theapi/pwm-charge-controller/README.md

# PWM Charge Controller

PWM solar charge controller, with common ground.
