theapi/pwm-charge-controller/datasheets/meter.jpg

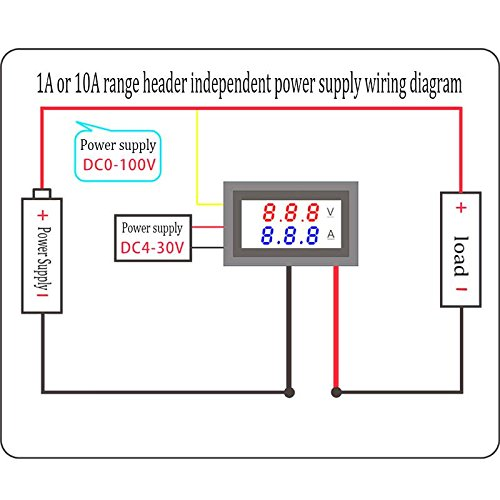
datasheets/meter.jpg
