theapi/pwm-charge-controller/kicad/render-bottom.png

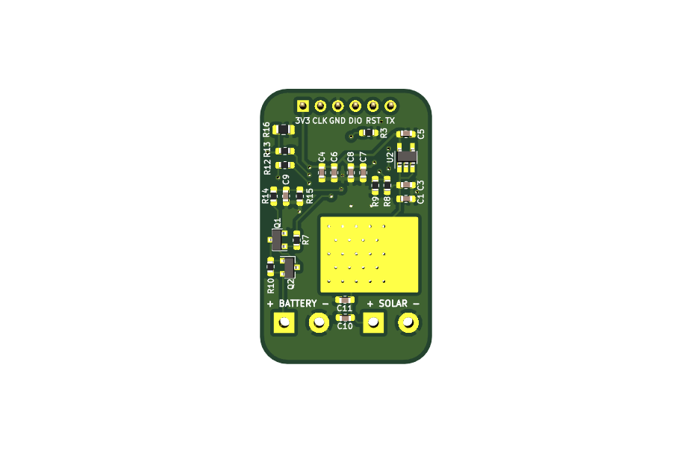
kicad/render-bottom.png
