theapi/pwm-charge-controller/kicad/project.pdf

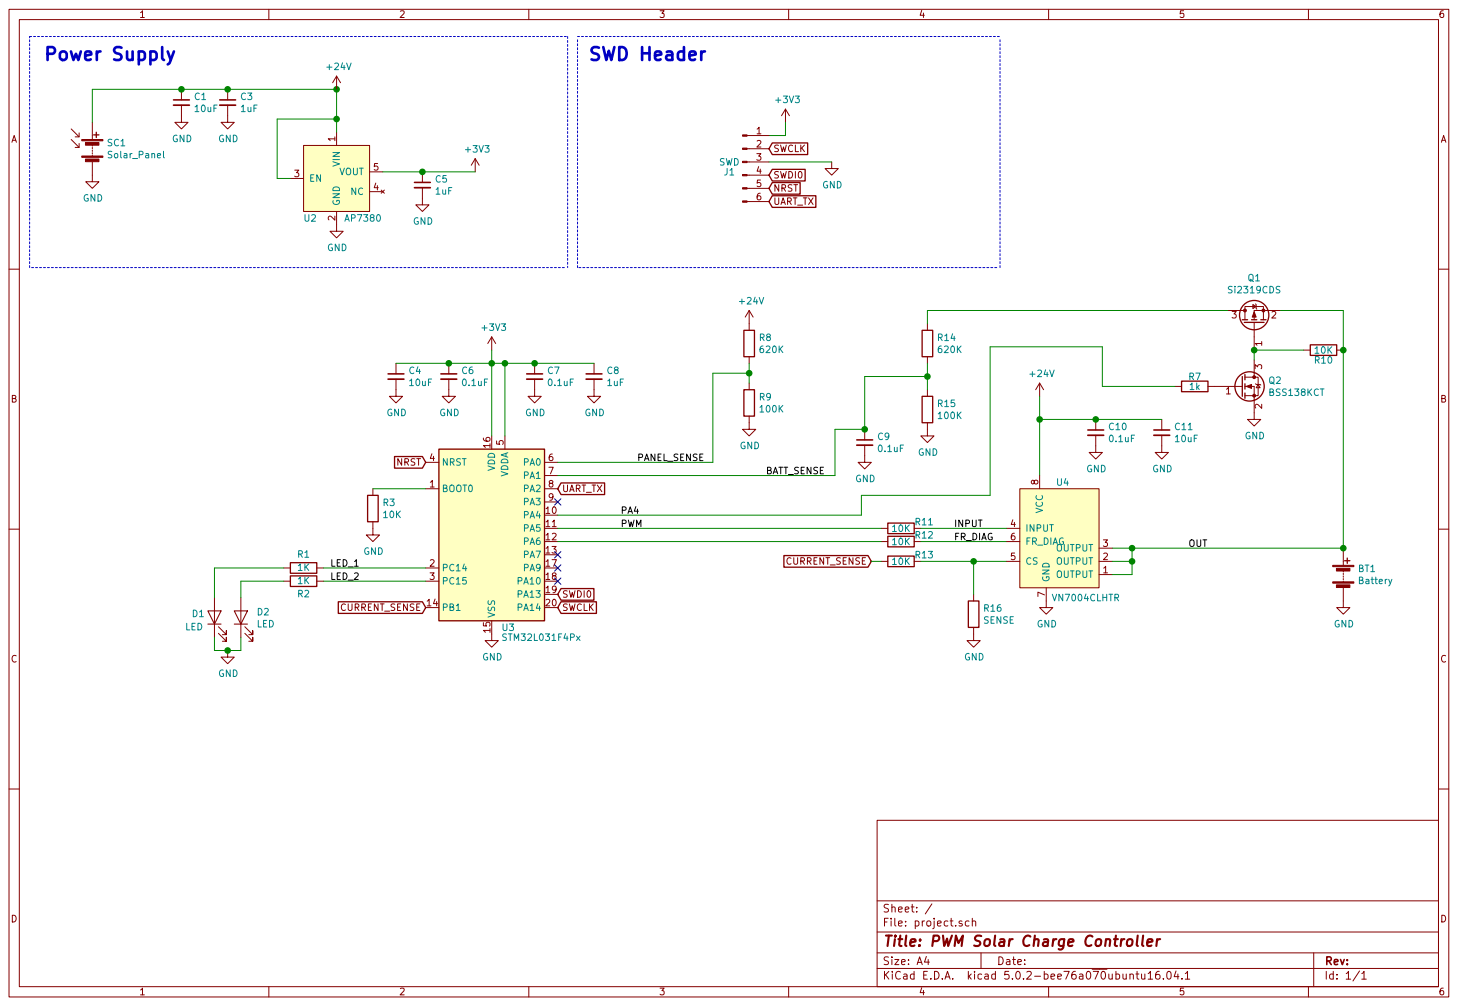
[picture p5: page 1]

Id: 1/1 Title: PWM Solar Charge Controller
