theapi/pwm-charge-controller/kicad/project/project.kicad_pcb

## KiCad design kicad/project/project.kicad_pcb (2019-07-06)

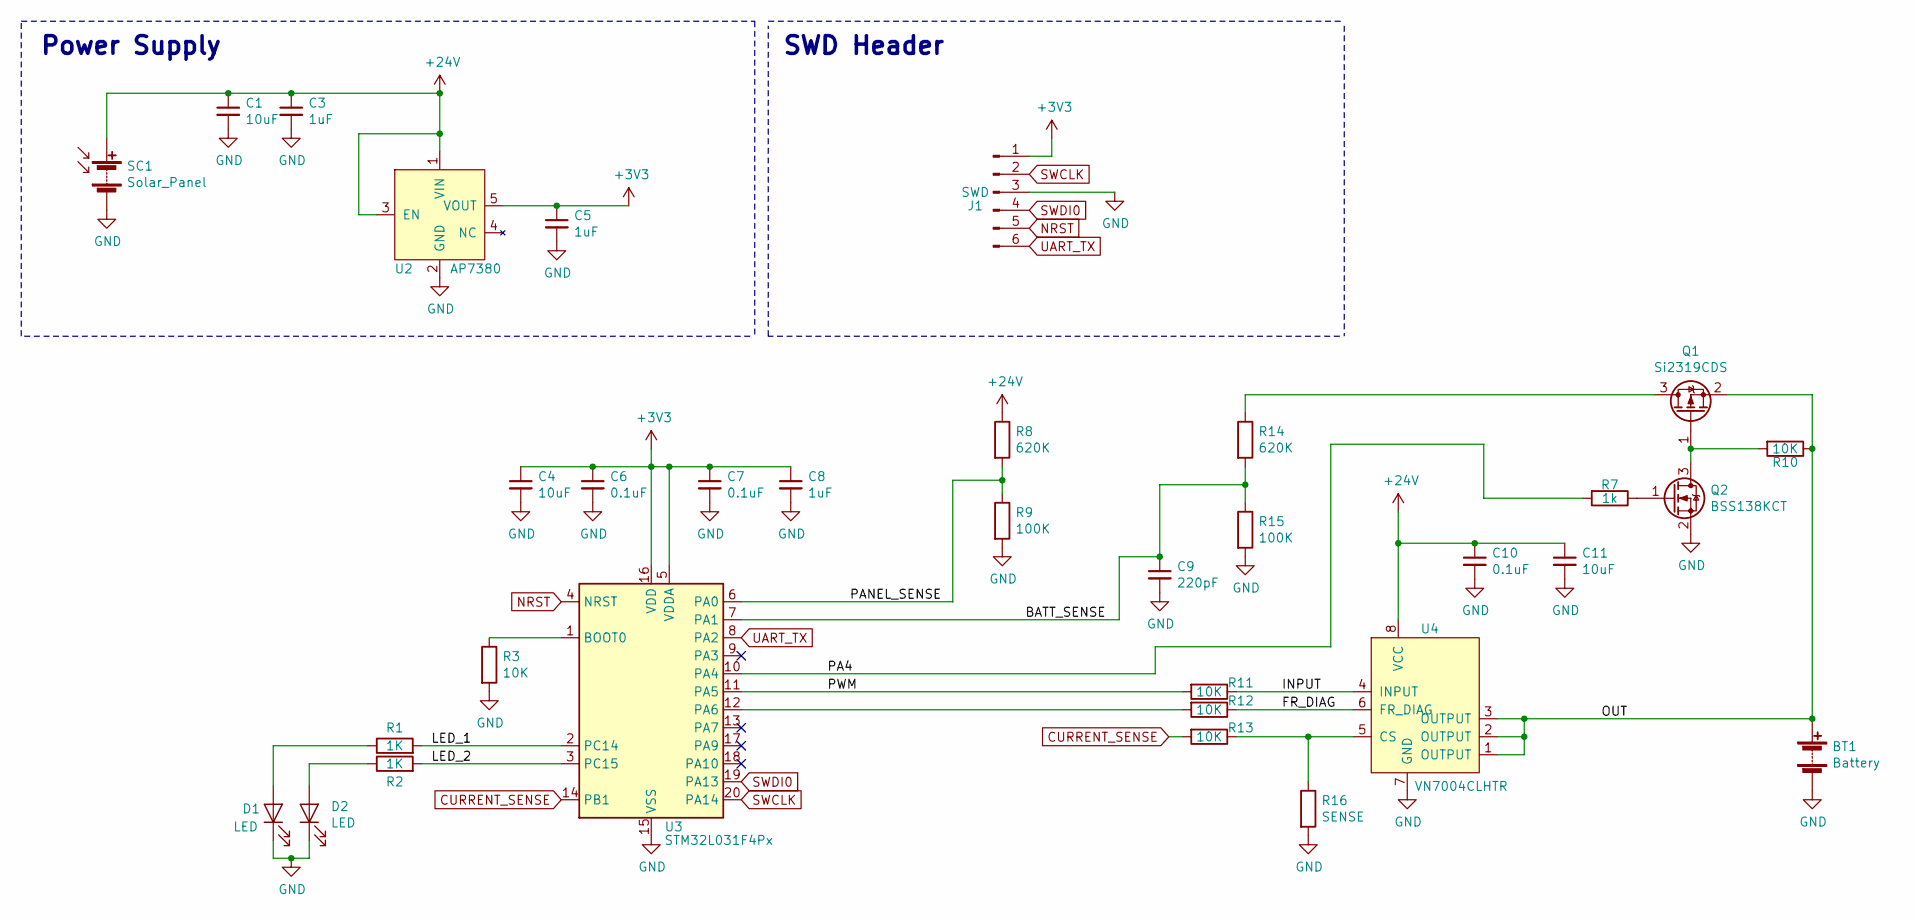
[picture p6: schematic project.sch, PWM Solar Charge Controller]

Parts:
BT1: Battery; TerminalBlock_2_P5.08mm
C1, C4, C11: 10uF; C_0603_1608Metric_Pad1.05x0.95mm_HandSolder
C3, C5, C8: 1uF; C_0603_1608Metric_Pad1.05x0.95mm_HandSolder
C6, C7, C10: 0.1uF; C_0603_1608Metric_Pad1.05x0.95mm_HandSolder
C9: 220pF; C_0603_1608Metric_Pad1.05x0.95mm_HandSolder
D1, D2: LED; LED_0805_2012Metric_Pad1.15x1.40mm_HandSolder
J1: SWD; PinHeader_1x06_P2.54mm_Vertical
Q1: Si2319CDS; SOT-23
Q2: BSS138KCT; SOT-23
R1, R2: 1K; R_0603_1608Metric_Pad1.05x0.95mm_HandSolder
R3, R10, R11, R12, R13: 10K; R_0603_1608Metric_Pad1.05x0.95mm_HandSolder
R7: 1k; R_0603_1608Metric_Pad1.05x0.95mm_HandSolder
R8, R14: 620K; R_0603_1608Metric_Pad1.05x0.95mm_HandSolder
R9, R15: 100K; R_0603_1608Metric_Pad1.05x0.95mm_HandSolder
R16: SENSE; R_0805_2012Metric_Pad1.15x1.40mm_HandSolder
SC1: Solar_Panel; TerminalBlock_2_P5.08mm
U2: AP7380; SOT-23-5_HandSoldering
U3: STM32L031F4Px; TSSOP-20_4.4x6.5mm_P0.65mm
U4: VN7004CLHTR; Octapak

Connections:
+3V3: C4.1, C5.1, C6.1, C7.1, C8.1, J1.1, U2.5 (VOUT), U3.5 (VDDA), U3.16 (VDD)
+24V: C1.1, C3.1, C10.1, C11.1, R8.1, SC1.1 (+), U2.1 (VIN), U2.3 (EN), U4.8 (VCC)
/BATT_SENSE: C9.1, R14.2, R15.1, U3.7 (PA1)
/FR_DIAG: R12.1, U4.6 (FR_DIAG)
/INPUT: R11.1, U4.4 (INPUT)
/LED_1: R1.2, U3.2 (PC14)
/LED_2: R2.2, U3.3 (PC15)
/OUT: BT1.1 (+), Q1.2 (S), R10.1, U4.1 (OUTPUT), U4.2 (OUTPUT), U4.3 (OUTPUT)
/PA4: R7.2, U3.10 (PA4)
/PANEL_SENSE: R8.2, R9.1, U3.6 (PA0)
/PWM: R11.2, U3.11 (PA5)
CURRENT_SENSE: R13.2, U3.14 (PB1)
GND: BT1.2 (-), C1.2, C3.2, C4.2, C5.2, C6.2, C7.2, C8.2, C9.2, C10.2, C11.2, D1.1 (K), D2.1 (K), J1.3, Q2.2 (S), R3.2, R9.2, R15.2, R16.2, SC1.2 (-), U2.2 (GND), U3.15 (VSS), U4.7 (GND)
NRST: J1.5, U3.4 (NRST)
unnamed: D1.2 (A), R1.1
unnamed: D2.2 (A), R2.1
unnamed: Q1.1 (G), Q2.3 (D), R10.2
unnamed: Q1.3 (D), R14.1
unnamed: Q2.1 (G), R7.1
unnamed: R3.1, U3.1 (BOOT0)
unnamed: R12.2, U3.12 (PA6)
unnamed: R13.1, R16.1, U4.5 (CS)
SWCLK: J1.2, U3.20 (PA14)
SWDI0: J1.4, U3.19 (PA13)
UART_TX: J1.6, U3.8 (PA2)

Notes on the sheet:
Power Supply
SWD Header

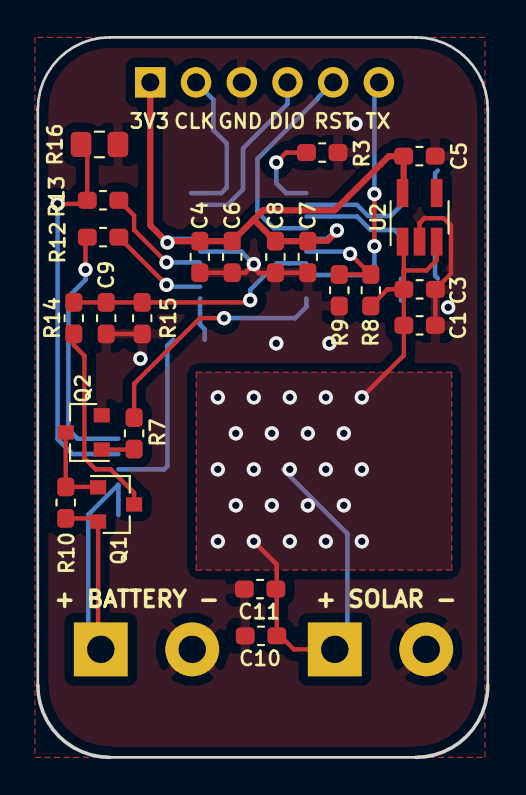
[picture p7: board project.kicad_pcb from above]

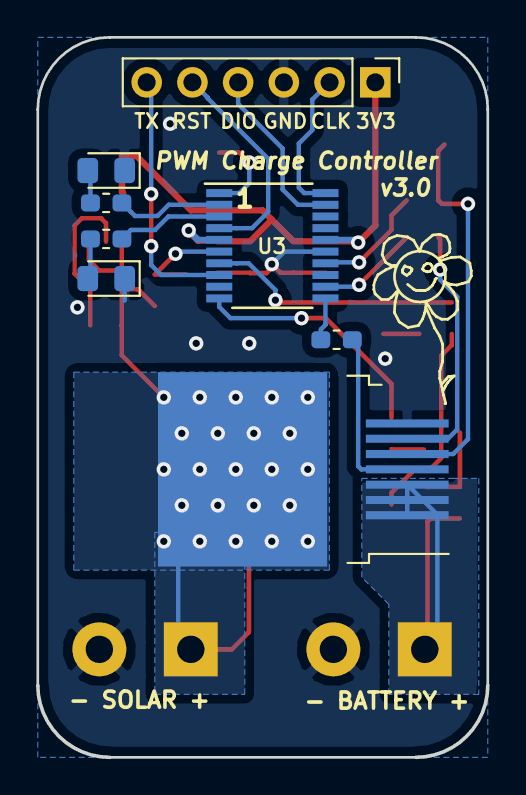
[picture p8: board project.kicad_pcb from below]

Board: 2 copper layers, 25.0 x 40.0 mm, 33 parts (10 on the bottom side), 25 nets.
