theapi/pwm-charge-controller/stm32/charge-controller/Src/main.c

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

/* Includes ------------------------------------------------------------------*/
#include "main.h"
#include "adc.h"
#include "comp.h"
#include "dma.h"
#include "tim.h"
#include "gpio.h"

/* USER CODE BEGIN Includes */

#include "string.h"
#include "stdio.h"

#include "led.h"


/* USER CODE END Includes */

/* USER CODE BEGIN PD */

/* Definition of ADCx conversions data table size */
#define ADC_CONVERTED_DATA_BUFFER_SIZE   ((uint32_t)  512)   /* Size of array aADCxConvertedData[] */

#define TXBUFFERSIZE 128
#define READING_INDEX_LENGTH 4


/* USER CODE END PD */


/* USER CODE BEGIN PV */
/* Variable containing ADC conversions data */
static uint16_t aADCxConvertedData[ADC_CONVERTED_DATA_BUFFER_SIZE];
static uint16_t avgPA1;
/* The comparator sets/resets this variable when comparing PA0 & PA1 */
volatile uint8_t comparator = 0;


/* Buffer used for debug UART */
char tx_buffer[TXBUFFERSIZE];
uint8_t msg_id = 0;

uint32_t tx_last;
uint32_t panel_mv = 0;
uint32_t battery_mv = 0;

LED_HandleTypeDef led1;
LED_HandleTypeDef led2;


/* USER CODE END PV */

void SystemClock_Config(void);
/**
  * @brief  The application entry point.
  * @retval int
  */
int main(void)
{
  

  /* MCU Configuration--------------------------------------------------------*/

  /* Reset of all peripherals, Initializes the Flash interface and the Systick. */
  HAL_Init();

  /* Configure the system clock */
  SystemClock_Config();

  /* Initialize all configured peripherals */
  MX_GPIO_Init();
  MX_DMA_Init();
  MX_TIM2_Init();
  MX_ADC_Init();
  MX_COMP1_Init();
  /* USER CODE BEGIN 2 */


  LED_Init(&led1, GPIOC, LED_1_Pin);
  led1.onDuration = 100;
  led1.offDuration = 900;

  LED_Init(&led2, GPIOC, LED_2_Pin);
  led2.offDuration = 500;
  LED_on(&led2);

  if (HAL_ADCEx_Calibration_Start(&hadc, ADC_SINGLE_ENDED) !=  HAL_OK)
  {
    Error_Handler();
  }

  HAL_COMP_Start(&hcomp1);

  /* Start conversion in DMA mode ################################# */
  if (HAL_ADC_Start_DMA(&hadc,
                        (uint32_t *)aADCxConvertedData,
                        ADC_CONVERTED_DATA_BUFFER_SIZE
                       ) != HAL_OK)
  {
    Error_Handler();
  }

  htim2.Instance->CCR1 = 0;
  HAL_TIM_PWM_Start(&htim2, TIM_CHANNEL_1);


  // This is the driver pin for connecting the battery to the adc.
  // So the battery can always be connected but present no voltage
  // to the adc until it is powered.
  HAL_GPIO_WritePin(GPIOA, GPIO_PIN_4, GPIO_PIN_SET);



  /* USER CODE END 2 */

  /* Infinite loop */
  /* USER CODE BEGIN WHILE */
  while (1)
  {
    /* USER CODE END WHILE */

    /* USER CODE BEGIN 3 */

	  uint32_t tmpAvgPA1 = 0;
	  uint16_t i = 0;
	  while (i < ADC_CONVERTED_DATA_BUFFER_SIZE) {
		  /* PA1 is the battery */
		  tmpAvgPA1 += aADCxConvertedData[i];
		  i++;
	  }
	  // Use the average.
 	  avgPA1 = tmpAvgPA1 / ADC_CONVERTED_DATA_BUFFER_SIZE;

	  // 2330 = 13519 = 5.802145923 per bit
 	  // 13609 = 2327 = 5.848302535
 	  // 2310 13523 5.854112554
	  battery_mv = (avgPA1 * 5854) / 1000;

	  // If the comparator says the panel is a higher voltage than the battery
	  // then charge.
	  if (comparator) {
		  if (battery_mv > 13510) {
			  if (htim2.Instance->CCR1 > 0) {
				  htim2.Instance->CCR1 -= 1;
			  }
		  } else if (battery_mv < 13490){
			  if (htim2.Instance->CCR1 < 1000) {
				  htim2.Instance->CCR1 += 1;
			  }
		  }
	  } else {
		  // Not enough to do charging.
		  htim2.Instance->CCR1 = 0;
	  }


	  /* Set the leds */
	  if (htim2.Instance->CCR1 == 1000) {
		  LED_on(&led2);
	  } else if (htim2.Instance->CCR1 == 0) {
		  LED_off(&led2);
	  } else {
		  led2.onDuration = htim2.Instance->CCR1;
		  LED_flash(&led2);
	  }

	  /* A continual flash to indicate powered on */
	  LED_flash(&led1);

	 // HAL_Delay(20);

//	  uint32_t now = HAL_GetTick();
//	  if (now - tx_last >= 500) {
//		  tx_last = now;
//		  int tx_len = snprintf(
//				  tx_buffer,
//				  TXBUFFERSIZE,
//				  "msg_id:%d, batt:%lu, panel:%lu, ccr:%lu \n",
//				  msg_id++,
//				  battery_mv,
//				  panel_mv,
//				  htim2.Instance->CCR1
//		  );
//		  HAL_UART_Transmit(&huart2, (uint8_t *)tx_buffer, tx_len, 500);
//	  }



  }
  /* USER CODE END 3 */
}

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
/* USER CODE BEGIN 4 */

void HAL_COMP_TriggerCallback(COMP_HandleTypeDef *hcomp) {
	if (HAL_COMP_GetOutputLevel(hcomp)) {
		comparator = 1;
	} else {
		comparator = 0;
	}
}

/* USER CODE END 4 */
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
