theapi/pwm-charge-controller/stm32/charge-controller/charge-controller.ioc

Mcu.UserName=STM32L031F4Px
PA0-CK_IN.Signal=COMP1_INM
PA1.Signal=SharedAnalog_PA1
PA13.Signal=SYS_SWDIO
PA14.Signal=SYS_SWCLK
PA4.Signal=GPIO_Output
PA5.GPIO_Label=PWM
PA5.Signal=S_TIM2_CH1
PA6.Signal=GPIO_Output
PC14-OSC32_IN.GPIO_Label=LED_1
PC14-OSC32_IN.Signal=GPIO_Output
PC15-OSC32_OUT.GPIO_Label=LED_2
PC15-OSC32_OUT.Signal=GPIO_Output
