theapi/pwm-charge-controller/stm32/charge-controller/Inc/main.h

#define LED_1_Pin GPIO_PIN_14
#define LED_1_GPIO_Port GPIOC
#define LED_2_Pin GPIO_PIN_15
#define LED_2_GPIO_Port GPIOC
#define PWM_Pin GPIO_PIN_5
#define PWM_GPIO_Port GPIOA
