theapi/pwm-charge-controller/(commit log)

2019-01-23 PWM at 10.4kHz
    [charge-controller Debug.cfg]
2019-01-23 Low pass filter
2019-01-24 UART debug
2019-02-24 About 60us rise and fall time
    [charge-controller Debug.cfg]
2019-03-02 Start of hardware
    [project.kicad_pcb, project.sch]
2019-03-02 AP7380 voltage regulator
    [project.sch]
2019-03-03 Removed temperature sensor
2019-03-06 Placing parts
    [project.kicad_pcb, project.sch]
2019-03-07 Panel mount meter
    [project.kicad_pcb, project.sch]
2019-03-09 Components placed
    [project.kicad_pcb, project.sch]
2019-03-09 Main power traces
    [project.kicad_pcb, project.sch]
2019-03-09 Avoid power fills
    [project.kicad_pcb]
2019-03-09 Zone priorities
    [project.kicad_pcb]
2019-03-10 Changed diode footprint
    [project.kicad_pcb, project.sch]
2019-03-10 SWD header
    [project.kicad_pcb]
2019-03-10 Input copper pour re-shape
    [project.kicad_pcb]
2019-03-10 Sense battery before the diode
    [project.kicad_pcb, project.sch]
2019-03-10 Voltmeter header
    [project.kicad_pcb, project.sch]
2019-03-13 Solder mask
    [project.kicad_pcb]
2019-03-14 Mounting holes
    [project.kicad_pcb, project.sch]
2019-03-16 Bit more room for the meter
    [project.kicad_pcb]
2019-04-03 Corrected octopak footprint
    [project.kicad_pcb]
2019-04-07 Start of external ADC
2019-04-07 Basic output voltage control
2019-04-09 BATT_SENSE RC filter fix
    [project.kicad_pcb, project.sch]
2019-04-09 Measure after the diode to get the battery voltage
    [project.kicad_pcb, project.sch]
2019-04-11 Removed extra resistor
    [project.kicad_pcb, project.sch]
2019-04-14 Battery voltage switched to the ADC
    [project.sch]
2019-04-14 Pull up
    [project.sch]
2019-04-20 Use the internal ADC
2019-05-05 Faster & no UART
2019-05-11 PWM for the charge pump
2019-05-11 Mosfet PWM 499Hz
2019-05-14 Start of PWM5 schematic
    [project.sch]
2019-05-15 PWM5 Schematic
    [project.sch]
2019-05-15 Start of layout
    [project.kicad_pcb, project.sch]
2019-05-16 Initial board layout
    [project.kicad_pcb, project.sch]
2019-05-18 Clearer schematic
    [project.kicad_pcb, project.sch]
2019-05-18 Board outline
    [project.kicad_pcb]
2019-05-18 Center layout
    [project.kicad_pcb]
2019-05-18 Simulated circuit
2019-05-19 Allow for solid connection to mosfet
    [project.kicad_pcb, project.sch]
2019-05-19 Heart to go in the potting mould
    [project-B.Cu.gbl, project-B.Mask.gbs, project-B.SilkS.gbo, project-Edge.Cuts.gm1, project-F.Cu.gtl, project-F.Mask.gts, project-F.SilkS.gto, project-NPTH.drl]
2019-05-19 Layout change
    [project-B.Cu.gbl, project-B.Mask.gbs, project-B.SilkS.gbo, project-Edge.Cuts.gm1, project-F.Cu.gtl, project-F.Mask.gts, project-F.SilkS.gto, project-NPTH.drl]
2019-05-21 Test points
    [project-B.Cu.gbl, project-B.Mask.gbs, project-B.SilkS.gbo, project-Edge.Cuts.gm1, project-F.Cu.gtl, project-F.Mask.gts, project-F.SilkS.gto, project-NPTH.drl]
2019-05-21 SOD 123F
    [project-B.Cu.gbl, project-B.Mask.gbs, project-B.SilkS.gbo, project-Edge.Cuts.gm1, project-F.Cu.gtl, project-F.Mask.gts, project-F.SilkS.gto, project-NPTH.drl]
2019-05-21 diode label
    [project-B.Cu.gbl, project-B.Mask.gbs, project-B.SilkS.gbo, project-Edge.Cuts.gm1, project-F.Cu.gtl, project-F.Mask.gts, project-F.SilkS.gto, project-NPTH.drl]
2019-06-02 LEDs on
2019-06-04 Calibrate the ADC
2019-06-04 Keep battery to set point
2019-06-05 Flashing leds
2019-06-05 Indicate the PWM duty cycle
2019-06-05 Only try to charge if there is enough voltage on the panel
2019-06-22 New layout
    [project.kicad_pcb, project.sch]
2019-06-23 Power ground
    [project.kicad_pcb]
2019-06-23 layout tweak
    [project.kicad_pcb]
2019-06-23 mosfet change
    [project.sch]
2019-06-25 131Hz PWM 2MHz clock
2019-06-26 Flashin leds
2019-07-05 Corrected mosfet labels
    [project.kicad_pcb]
2019-07-06 Swapped the leds
2019-07-22 Status LED
2019-08-11 Migrate to STM32CubeIDE
    [charge-controller Debug.cfg]
2019-08-11 ADC via DMA & comparator
2019-08-11 Only one ADC input
2019-08-17 Large battery sense cap & larger sample buffer
    [project.sch]
